alfredkievit/GrowattModbus-ESP32C6-Homeassistant/hardware/C6_Growatt_Modbus.stl

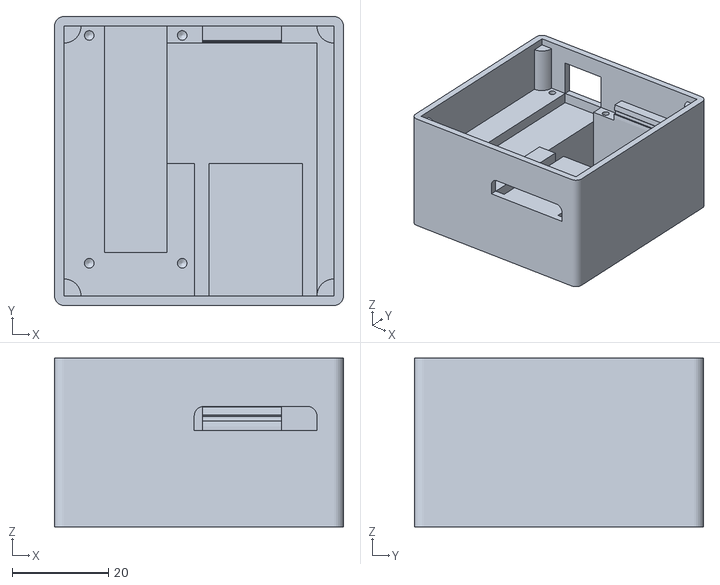
[picture p2: CAD file, 2026-10-30]
hardware/C6_Growatt_Modbus.stl
60.0 x 60.0 x 35.0
