alfredkievit/GrowattModbus-ESP32C6-Homeassistant/hardware/growatt_C6_box.stl

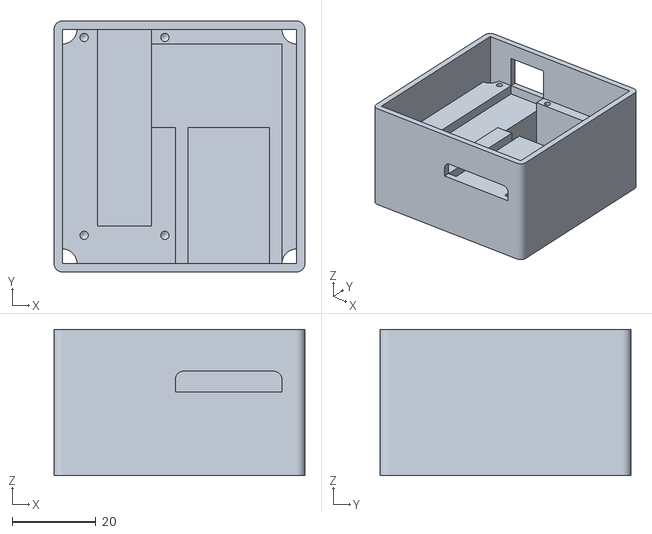
[picture p3: CAD file, 2026-10-26]
hardware/growatt_C6_box.stl
60.0 x 60.0 x 35.0
