alfredkievit/GrowattModbus-ESP32C6-Homeassistant/(commit log)

2026-10-26 Growatt Modbus naar Home Assistant met ESP32-C6 en ESPHome
    Claude-Session: https://claude.ai/code/session_01GTCWVUk2m2tLbE8xrvbhKY
2026-10-26 Behuizing (STL) en README-sectie toegevoegd
    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
    [growatt_C6_box.stl]
2026-10-26 Render van de behuizing in README
    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
2026-10-30 Behuizing: nieuwe STL C6_Growatt_Modbus toegevoegd
    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
    [C6_Growatt_Modbus.stl]
